Hofmen/KNEX-Controller/pijltje v3.stl

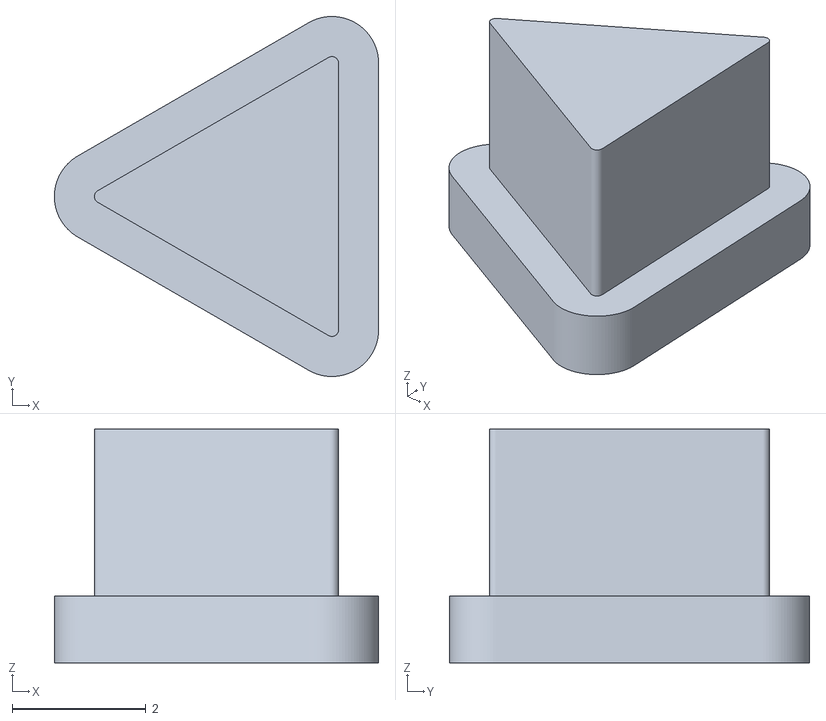
[picture p35: CAD file, 2025-03-10]
pijltje v3.stl
4.86 x 5.39 x 3.50
