Hofmen/KNEX-Controller/Onderkant controller v4.stl

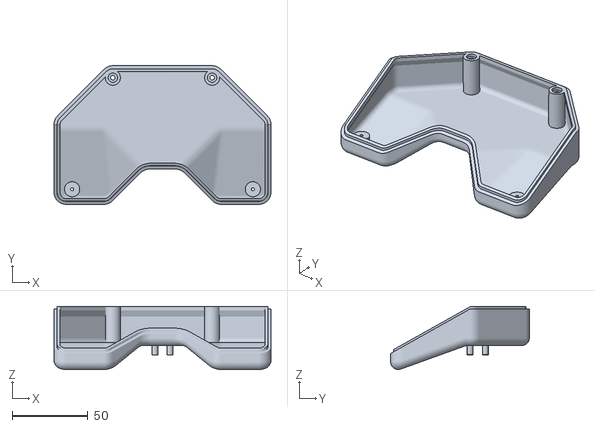
[picture p36: CAD file, 2025-03-10]
Onderkant controller v4.stl
143.6 x 91.8 x 41.7
