Hofmen/KNEX-Controller/kapje ontvanger v1.stl

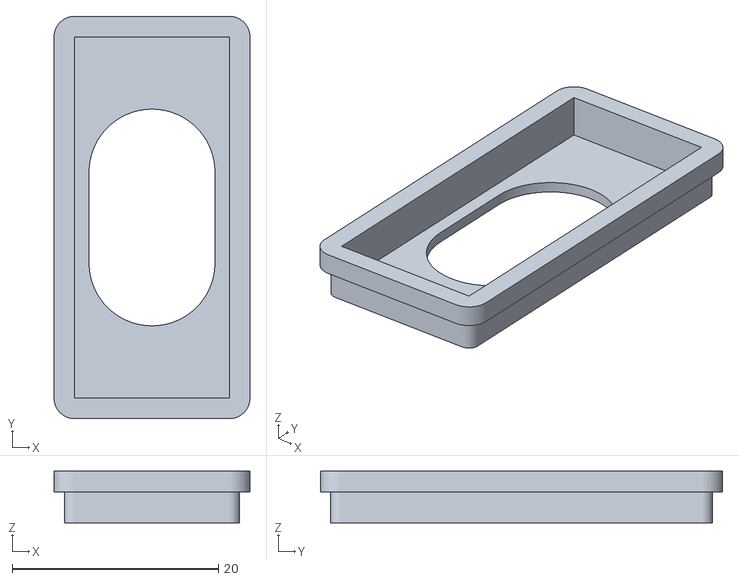
[picture p37: CAD file, 2025-03-10]
kapje ontvanger v1.stl
19.0 x 39.0 x 5.00
