Hofmen/KNEX-Controller/Bovenkant controller v4.stl

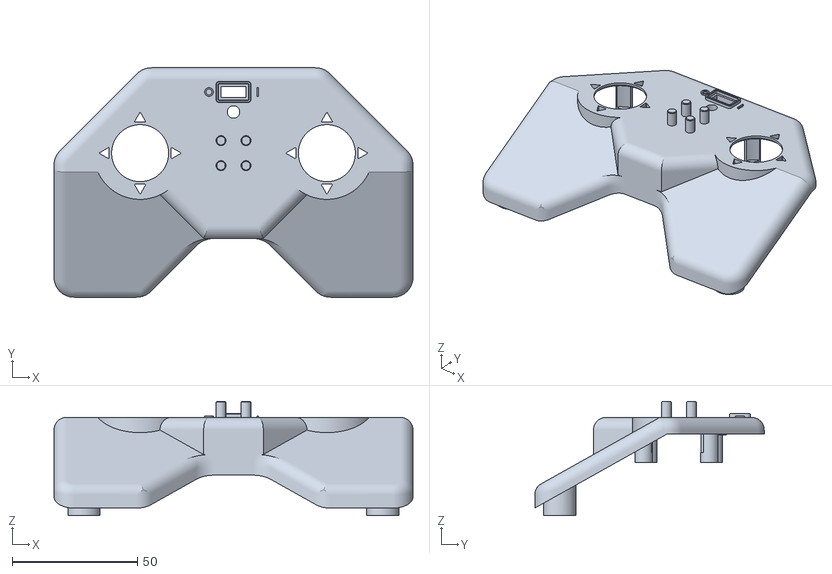
[picture p38: CAD file, 2025-03-10]
Bovenkant controller v4.stl
143.6 x 91.8 x 45.7
