Hofmen/KNEX-Controller/ontvanger v2 onderkant.stl

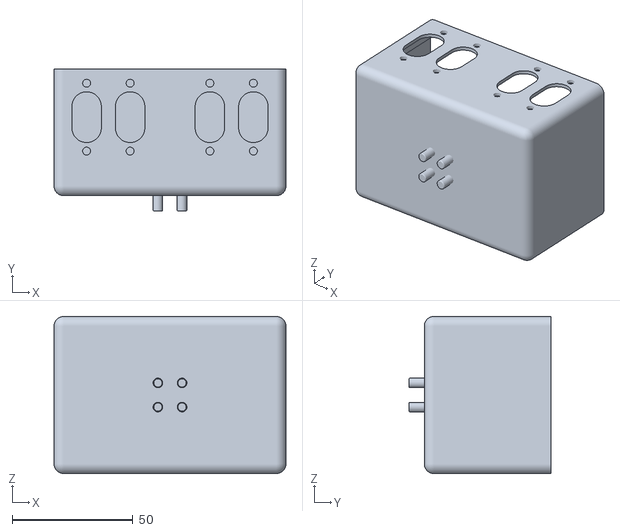
[picture p39: CAD file, 2025-03-10]
ontvanger v2 onderkant.stl
96.0 x 58.9 x 65.0
